pineindustries/arduino-tpms/README.md

<p align="center">
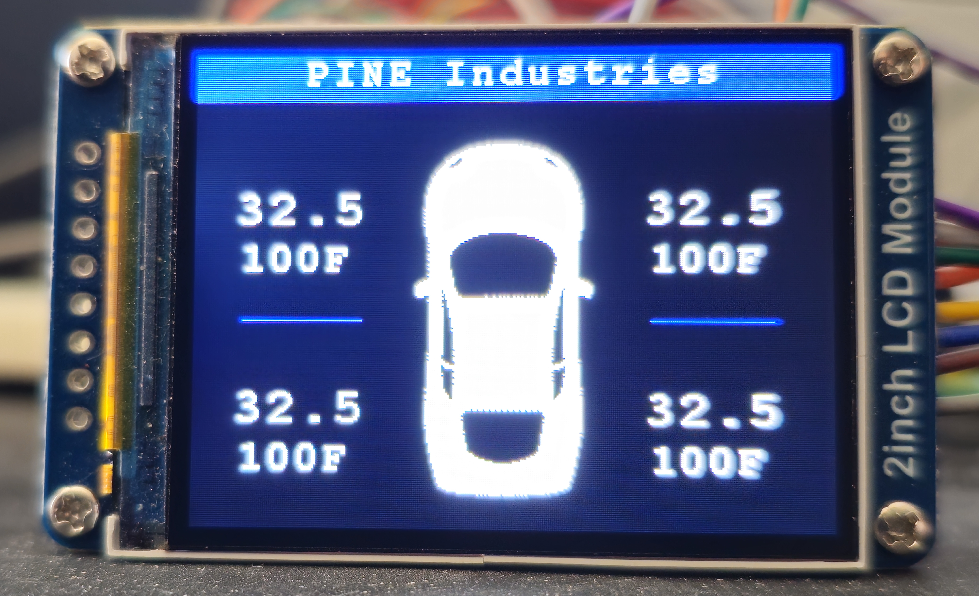
[picture p1: fig/lcd.jpg]
  
</p>

# arduino-tpms
An Arduino-based Tire Pressure Monitoring System (TPMS) receiver and LCD display.

# The Little Microcontroller That Could
The objective of this project was to see if we could fit a fully functioning TPMS receiver on a small microcontroller. The Arduino fits this description and proved quite a challenge. We leveraged most of the available on-board resources, used the CC1101 to off-load signal processing, and implemented a few software tricks: To display the car icon, we used a basic compression algorithm for the image data and allocated the image to the Arduino's PROGMEM thus avoiding the Arduino's flash memory.  We programmed the interrupt function, executed when a packet is received, to run and terminate as fast and as soon as possible. This allows the Arduino to return to an RX state quickly to continue process incoming packets. Packet data and status are kept in volatile memory thereby providing data integrity while the microcontroller updates the LCD, a relatively slow process.

# The Texas Instruments CC1101 Sub-1 GHz Transceiver
We strongly recommend reading TI's documentation cover-to-cover including errata. See the ./ref folder for details. And TI's Smart RF Software is a must (see below).

# TPMS Sensor
- [Schrader 433 MHz Sensor, Part Number: 29086](https://www.rockauto.com/en/moreinfo.php?pk=10672248)\
  Other part numbers may work, as well. Other venders, though, may require major code changes.

# Receiver Hardware
- [Arduino Pro Mini 328 - 5V/16MHz](https://www.sparkfun.com/arduino-pro-mini-328-5v-16mhz.html)\
  In testing, the 3.3V/8MHz board appeared too slow to meet our processing requirements.\
  [AtMega328P Datasheet](https://www.microchip.com/en-us/product/ATmega328P)
- [SparkFun FTDI Basic Breakout - 5V](https://www.sparkfun.com/sparkfun-ftdi-basic-breakout-5v.html)\
  Mostly required for testing/programming the Arduino. The final version should be hardwired to USB power without an FTDI breakout.
- [CC1101 Wireless Module with SMA Antenna Wireless Transceiver Module 315/433/868/915MHZ](https://www.amazon.com/MELIFE-CC1101-Wireless-Antenna-Transceiver/dp/B0F7XGBX65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)
- [Adafruit TLV62569 3.3V Buck Converter Breakout](https://www.adafruit.com/product/4711)\
  Required to convert the Arduino's 5V on-board power to 3.3V for the CC1101.
- [Waveshare 2 Inch LCD Module](https://www.amazon.com/2inch-IPS-LCD-Display-Module/dp/B082GFTZQD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)\
[Waveshare's Wiki Page on the 2" Display](https://www.waveshare.com/wiki/2inch_LCD_Module)

### Hardware Pin Configuration
The software currently supports the following pin configuration (see ./tpms/config.h). Arduino pins 11, 12, and 13 are associated with the SPI interface and must be configured as depicted below.
| Arduino Pin # | LCD Pin | CC1101 Pin |
| --- | --- | --- |
| 2 | | GDO2 |
| 3 | RST | |
| 4 | BL  | |
| 5 | DC  | |
| 7 | CS  | |
| 10  | | CSN  |
| 11  | DIN | MOSI |
| 12  | | MISO |
| 13  | CLK | SCK  |

# EMI Shielding
<p align="left">
  
</p>
The receiver seemed quite susceptible to Electromagnetic Interference (EMI). We tended to receive packets more reliably by using a shielded case and by shielding each wire. Be sure to connect the shielding to ground.

# Test Equipment
- [VXDAS TPMS Relearn Tool](https://www.amazon.com/VXDAS-EL-50448-Pressure-Monitor-Activation/dp/B072BK693N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)
- [Anti-Static ESD Mat](https://www.amazon.com/Electronics-HPFIX-Grounding-Soldering-Resistant/dp/B08FHQDKDH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)

# Test Software
- [Texas Instruments SmartRF Studio 7](https://www.ti.com/tool/SMARTRFTM-STUDIO)

# Development Environment
We love Microsoft's [VS Code](https://code.visualstudio.com/) with the [Platform.io Extension](https://platformio.org/install/ide?install=vscode). If you prefer the official [Arduino IDE](https://www.arduino.cc/en/software/), the Pro Mini may require the Legacy Version.

# The Schrader TPMS Signal and Raw Data
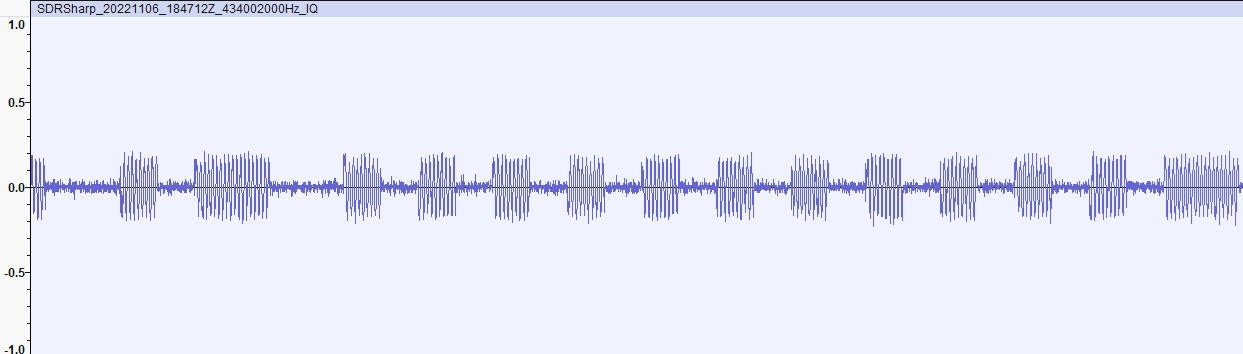
[picture p3: fig/signal.png]

Recorded using the [Nooelec RTL-SDR](https://www.amazon.com/Nooelec-RTL-SDR-SDR-100kHz-1-75GHz-Enclosure/dp/B01HA642SW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) with [SDRSharp](https://airspy.com/download/) and displayed with [Audacity](https://www.audacityteam.org/download/)
- **Frequency**: 433.92 MHz
- **Modulation**: ASK/OOK
- **Encoding**: Manchester
- **Packet Length**: 96 Bits, 80 bits less sync pattern
### Packet Structure:
```
Byte: 0... 4... 8... 12
      SSSU UUAA AAPT C
   S: Sync Pattern
   U: Unknown (Battery Status, Other Flags?)
   A: Sensor ID Number
   P: Pressure Byte
   T: Temperature Byte (°F = (T - 60) * 9/5 + 32)
   C: Checksum Byte
```

## Checksum Calculation
```math
\begin{flalign}
&C = \left( \sum_{i=3}^{11} b_i \right) \land 0xFF&&
\end{flalign}
```

# Thanks
[LSatan for the SmartRC CC1101 Driver Library](https://github.com/LSatan/SmartRC-CC1101-Driver-Lib)\
[merbanan's rtl-433 also helped debugging and testing](https://github.com/merbanan/rtl_433)
