pineindustries/arduino-tpms/src/tpms/config.h

// Arduino SPI
#define PIN_SCK   13 // Clock
#define PIN_MISO  12 // Master In / Slave Out
#define PIN_MOSI  11 // Master Out / Slave In

// CC1101
#define PIN_CS0    10        // SPI Chip Select
#define PIN_GDO0   2         // Digital I/O
#define SPI_SPEED  16000000  // SPI Bus Speed, Hz

// LCD
#define PIN_CS1  7  // SPI Chip Select
#define PIN_RST  3  // Reset
#define PIN_BL   4  // Backlight
#define PIN_DC   5  // Data/Command Control
