pineindustries/arduino-tpms/src/tpms/icon.h

const uint8_t icon[787] PROGMEM = { 
  126,2,1,13,1,1,67,27,59,35,53,40,
  48,44,44,47,41,51,38,4,2,41,2,5,
  34,5,3,42,3,4,33,4,3,43,4,4,
  31,3,4,46,3,4,29,3,3,50,2,4,
  27,64,25,65,24,67,23,68,21,69,20,71,
  19,71,19,72,17,73,17,74,15,75,15,75,
  15,75,15,76,13,77,13,77,13,77,13,78,
  12,77,13,78,12,78,11,79,12,78,11,79,
  12,78,11,79,12,78,11,79,12,78,11,79,
  12,78,12,78,12,77,13,31,15,31,13,26,
  25,26,14,22,32,22,14,20,36,20,14,18,
  40,17,16,15,44,15,15,15,46,14,16,13,
  48,13,15,13,50,12,16,11,51,12,16,11,
  52,11,15,11,53,11,16,10,54,10,15,11,
  54,10,16,10,54,10,16,10,53,11,15,11,
  54,10,16,10,53,11,15,11,53,11,16,11,
  52,11,16,11,52,11,15,12,51,12,16,11,
  51,12,15,13,50,13,12,15,50,15,8,17,
  50,17,5,18,49,19,3,19,49,20,2,20,
  48,6,1,13,2,13,1,6,47,6,1,14,
  2,13,1,7,46,6,1,14,2,14,1,6,
  45,7,1,13,4,3,3,6,2,8,12,1,
  3,1,2,1,1,1,1,1,2,1,1,1,
  1,1,2,1,1,1,1,1,2,1,1,7,
  2,7,4,2,10,7,1,57,2,7,15,7,
  3,56,2,7,16,6,3,56,2,7,16,7,
  2,56,2,7,16,6,3,55,3,7,16,7,
  3,54,3,7,16,7,3,54,3,7,16,7,
  3,54,3,7,16,7,3,53,4,7,16,7,
  3,54,3,7,16,7,4,52,4,7,16,7,
  4,52,4,7,16,7,4,52,4,7,16,7,
  4,52,4,7,16,7,4,51,5,7,16,7,
  5,51,4,7,16,7,4,51,5,7,16,7,
  5,50,5,7,16,7,5,50,5,7,16,7,
  5,50,5,7,16,7,5,50,5,7,16,7,
  5,50,5,7,16,7,5,50,5,7,16,7,
  5,50,5,7,16,7,5,50,5,7,16,7,
  5,49,6,7,16,7,6,49,5,7,16,7,
  5,49,6,7,15,8,5,50,5,7,16,6,
  7,48,6,7,15,7,6,50,6,6,16,7,
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
};
