pineindustries/arduino-tpms/(commit log)

2025-09-11 Update and rename tpms.ino to arduino-tpms.ino
2025-09-11 Upload case.jpg
