pineindustries/arduino-tpms/fig/case.jpg

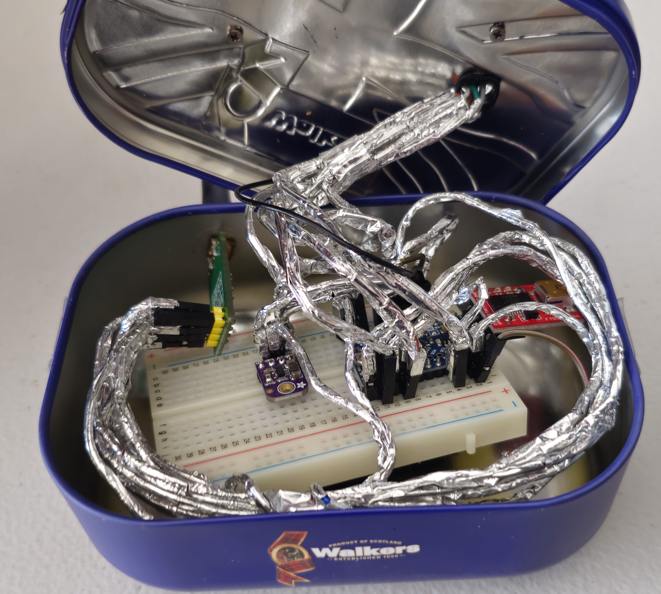
[picture p2: fig/case.jpg]
fig/case.jpg
